ameerry1998/Nema-17-23-planetary-gear/variants/banebots-775-k6/THIRD-PARTY.md

# Attribution

The parent project is Omar Salem's `Nema-17-23-planetary-gear`, distributed under the MIT license retained at [the repository root](../../LICENSE). The original Fusion models, STEP files, assets and source retain their existing attribution.

The additional Python generator in this folder uses `cq_gears` at commit `e73874cf17a25447a99b1e7c22a4d5af38560e9c` as an external dependency. Its [source](https://github.com/meadiode/cq_gears/tree/e73874cf17a25447a99b1e7c22a4d5af38560e9c) is Apache-2.0 licensed. No copy of its library implementation is included in this fork addition; installation retrieves the dependency and its license.

The fit-test geometry was generated with that dependency. It is an independent preliminary fit study, not a conversion of Omar Salem's Fusion models and not a representation of his design's tested capacity.

New variant code and documentation are provided under the repository's MIT license. Initial preparation: Codex, October 21, 2026.
