ameerry1998/Nema-17-23-planetary-gear/variants/banebots-775-k6/drive-candidate/S2-internal-preview.png

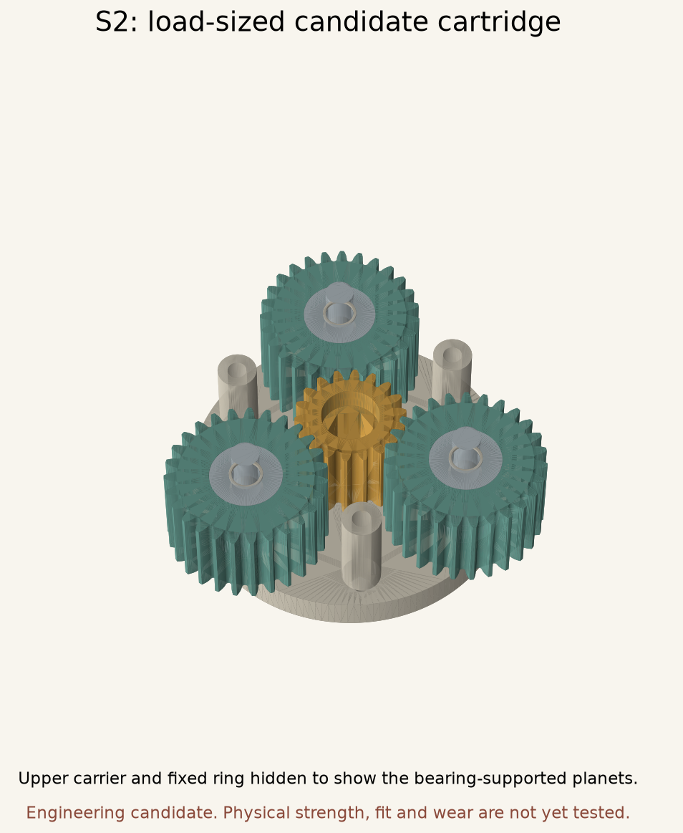
variants/banebots-775-k6/drive-candidate/S2-internal-preview.png
