ameerry1998/Nema-17-23-planetary-gear/variants/banebots-775-k6/cad/hand-test-assembly-REFERENCE.step

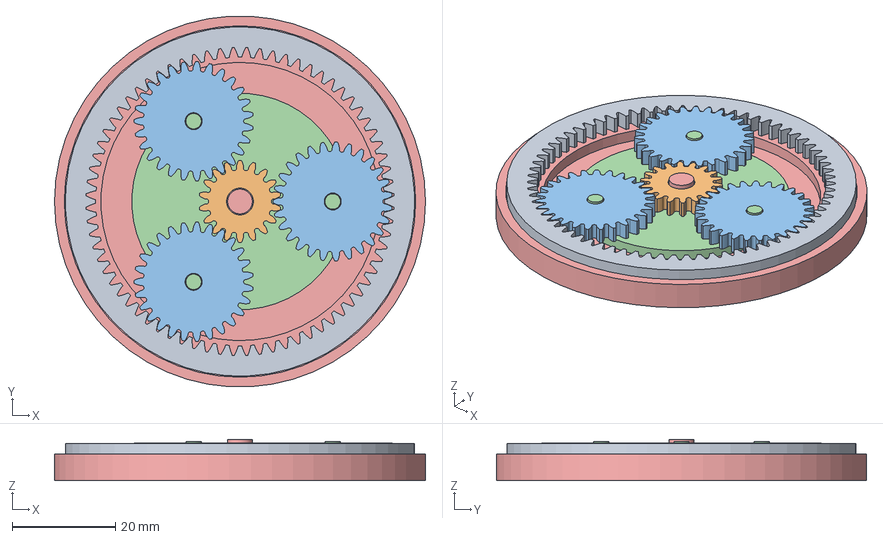
[picture p5: CAD file, 2026-10-21]
variants/banebots-775-k6/cad/hand-test-assembly-REFERENCE.step
72.0 x 71.9 x 8.00 mm
