ameerry1998/Nema-17-23-planetary-gear/variants/banebots-775-k6/drive-assembly/S2-output-cap-retainer-top.step

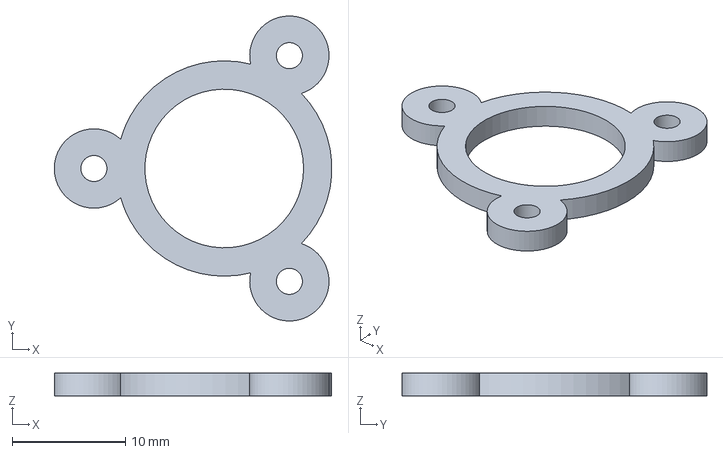
[picture p6: CAD file, 2026-10-21]
variants/banebots-775-k6/drive-assembly/S2-output-cap-retainer-top.step
24.5 x 26.9 x 2.00 mm
