ameerry1998/Nema-17-23-planetary-gear/variants/banebots-775-k6/drive-candidate/S2-sun.step

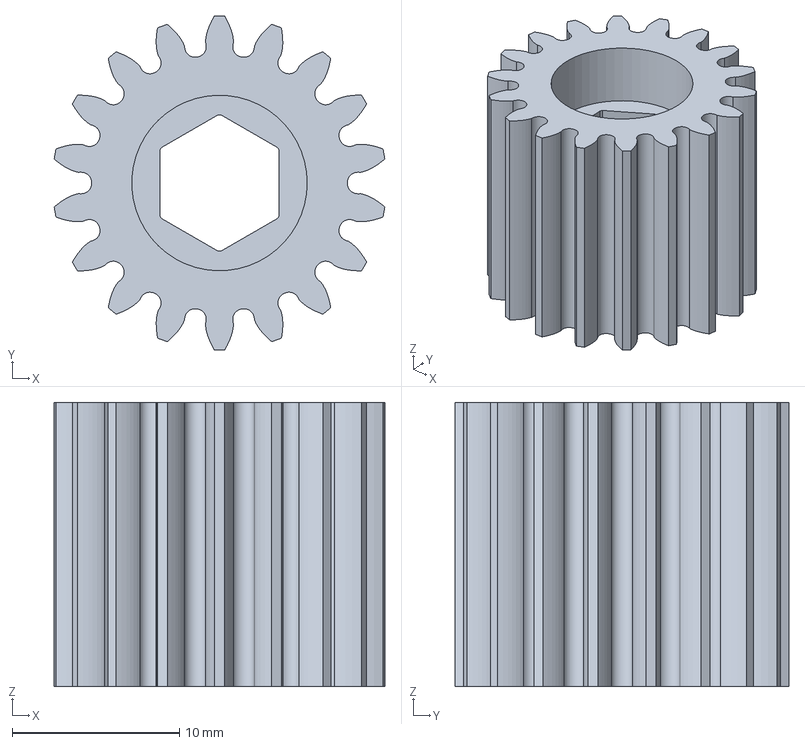
[picture p7: CAD file, 2026-10-21]
variants/banebots-775-k6/drive-candidate/S2-sun.step
19.8 x 20.0 x 17.0 mm
