ameerry1998/Nema-17-23-planetary-gear/variants/banebots-775-k6/fit-tests/shaft-fit-5.0mm-NO-POWER.step

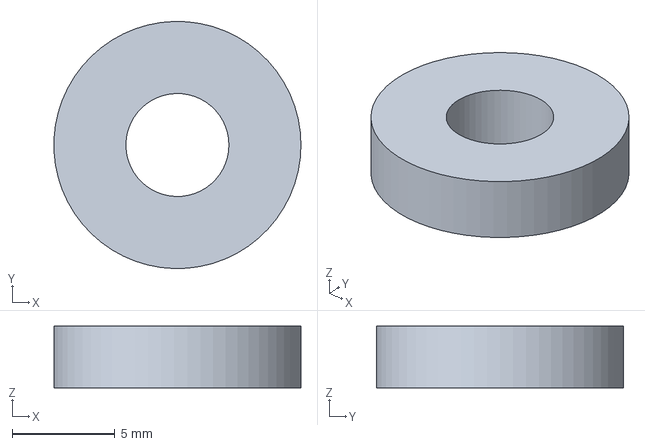
[picture p8: CAD file, 2026-10-21]
variants/banebots-775-k6/fit-tests/shaft-fit-5.0mm-NO-POWER.step
12.0 x 12.0 x 3.00 mm
