ameerry1998/Nema-17-23-planetary-gear/variants/banebots-775-k6/socket-adapter/SA1-REFERENCE.step

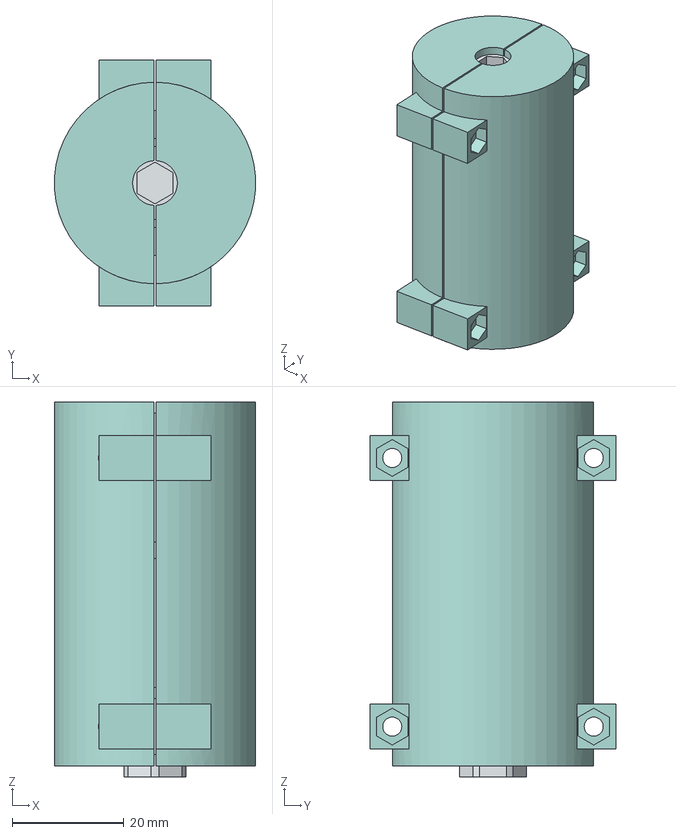
[picture p9: CAD file, 2026-10-21]
variants/banebots-775-k6/socket-adapter/SA1-REFERENCE.step
35.9 x 44.0 x 67.0 mm
left
right
input-steel-socket-envelope
output-steel-socket-envelope
steel-square-bridge-envelope
existing-metal-collar-envelope
12REX-output-shaft-envelope
