ameerry1998/Nema-17-23-planetary-gear/variants/banebots-775-k6/static-fixture/TF1-tie-rod-standoff-STATIC-ONLY.step

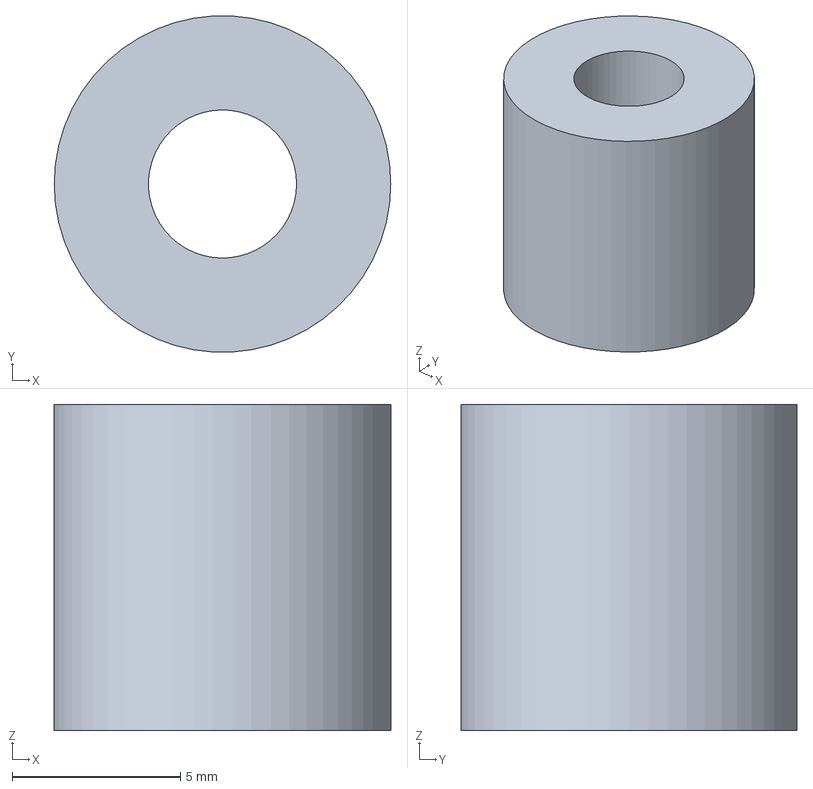
[picture p10: CAD file, 2026-10-21]
variants/banebots-775-k6/static-fixture/TF1-tie-rod-standoff-STATIC-ONLY.step
10.0 x 9.98 x 9.70 mm
