ameerry1998/Nema-17-23-planetary-gear/variants/banebots-775-k6/cad/single-stage-mesh-REFERENCE.step

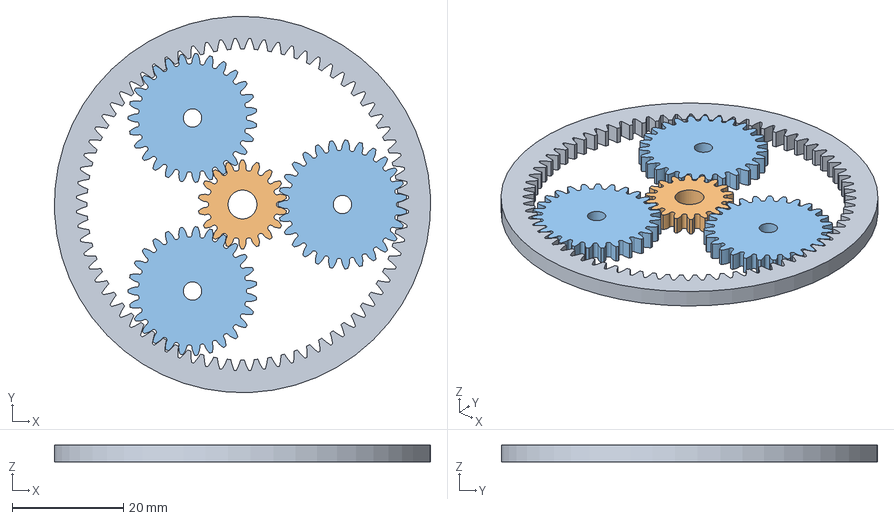
[picture p11: CAD file, 2026-10-21]
variants/banebots-775-k6/cad/single-stage-mesh-REFERENCE.step
67.7 x 67.7 x 3.00 mm
