ameerry1998/Nema-17-23-planetary-gear/variants/banebots-775-k6/drive-assembly/input-coupler-bearing-spacer.step

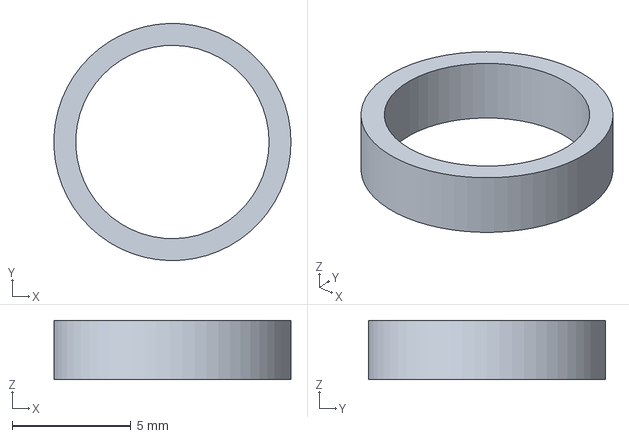
[picture p12: CAD file, 2026-10-21]
variants/banebots-775-k6/drive-assembly/input-coupler-bearing-spacer.step
9.99 x 10.00 x 2.50 mm
