ameerry1998/Nema-17-23-planetary-gear/variants/banebots-775-k6/drive-candidate/S2-carrier-upper.step

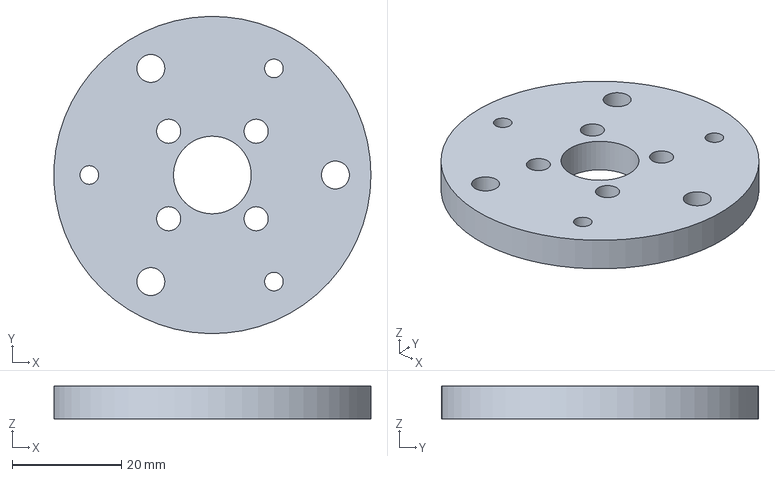
[picture p13: CAD file, 2026-10-21]
variants/banebots-775-k6/drive-candidate/S2-carrier-upper.step
58.0 x 58.0 x 6.00 mm
