ameerry1998/Nema-17-23-planetary-gear/variants/banebots-775-k6/fit-tests/motor-face-slotted-TEMPLATE-NO-POWER.step

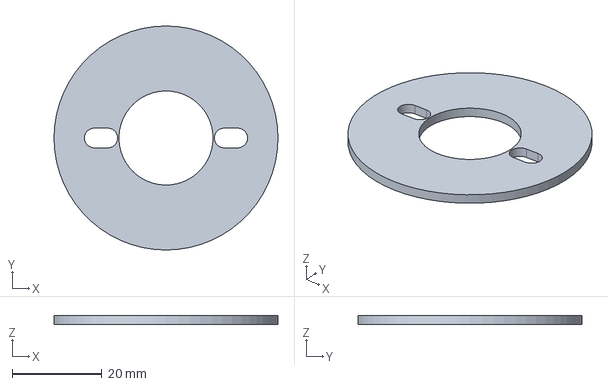
[picture p14: CAD file, 2026-10-21]
variants/banebots-775-k6/fit-tests/motor-face-slotted-TEMPLATE-NO-POWER.step
50.0 x 50.0 x 2.00 mm
