ameerry1998/Nema-17-23-planetary-gear/variants/banebots-775-k6/socket-adapter/SA1-cassette-right.step

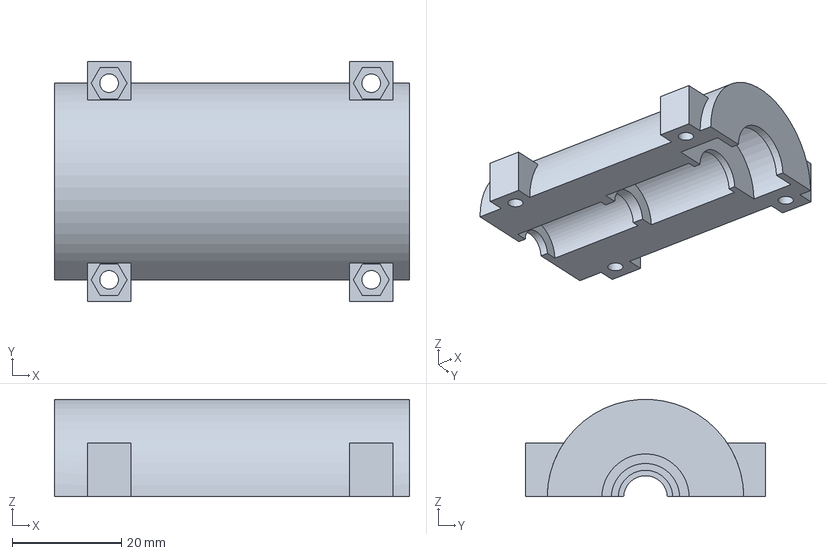
[picture p15: CAD file, 2026-10-21]
variants/banebots-775-k6/socket-adapter/SA1-cassette-right.step
65.0 x 44.0 x 17.8 mm
