ameerry1998/Nema-17-23-planetary-gear/variants/banebots-775-k6/static-fixture/TF1-vise-plate-MOTOR-REMOVED-ONLY.step

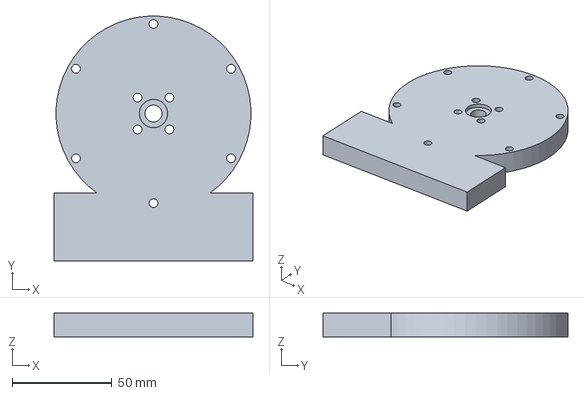
[picture p16: CAD file, 2026-10-21]
variants/banebots-775-k6/static-fixture/TF1-vise-plate-MOTOR-REMOVED-ONLY.step
100.0 x 122.9 x 12.0 mm
