ameerry1998/Nema-17-23-planetary-gear/variants/banebots-775-k6/drive-assembly/S2-case-lower.step

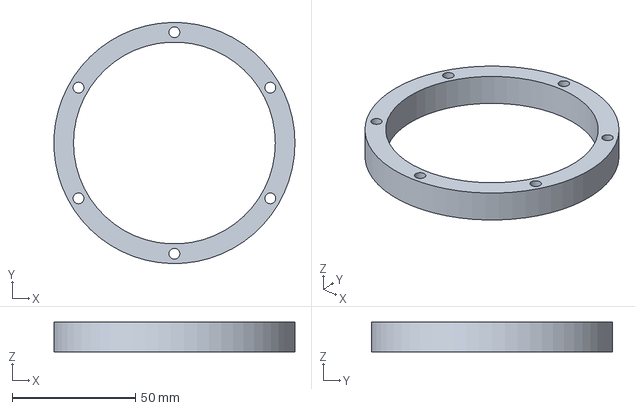
[picture p17: CAD file, 2026-10-21]
variants/banebots-775-k6/drive-assembly/S2-case-lower.step
97.9 x 98.0 x 12.0 mm
