ameerry1998/Nema-17-23-planetary-gear/variants/banebots-775-k6/socket-adapter/SA1-output-collar-spacer-FIT-SAMPLE.step

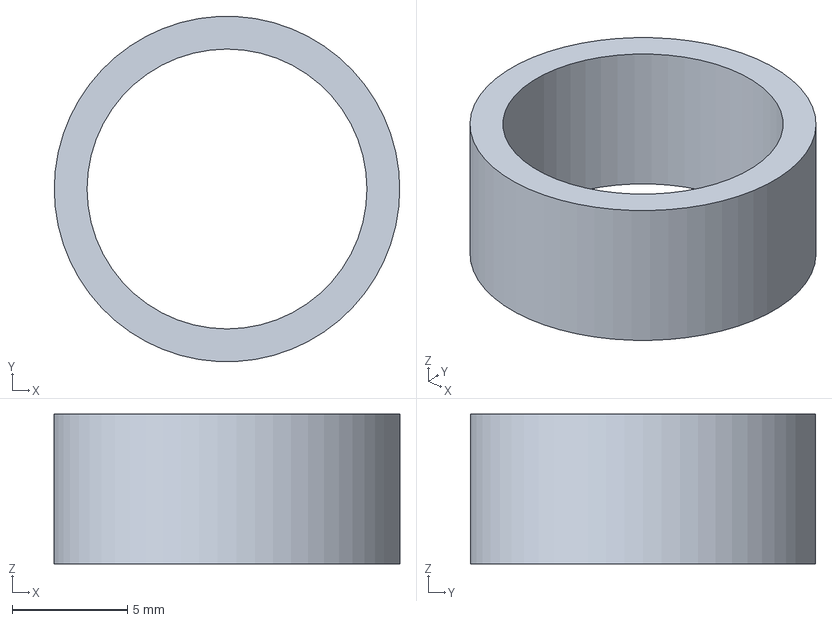
[picture p19: CAD file, 2026-10-21]
variants/banebots-775-k6/socket-adapter/SA1-output-collar-spacer-FIT-SAMPLE.step
15.0 x 15.0 x 6.50 mm
