ameerry1998/Nema-17-23-planetary-gear/variants/banebots-775-k6/static-fixture/TF1-STATIC-REFERENCE.step

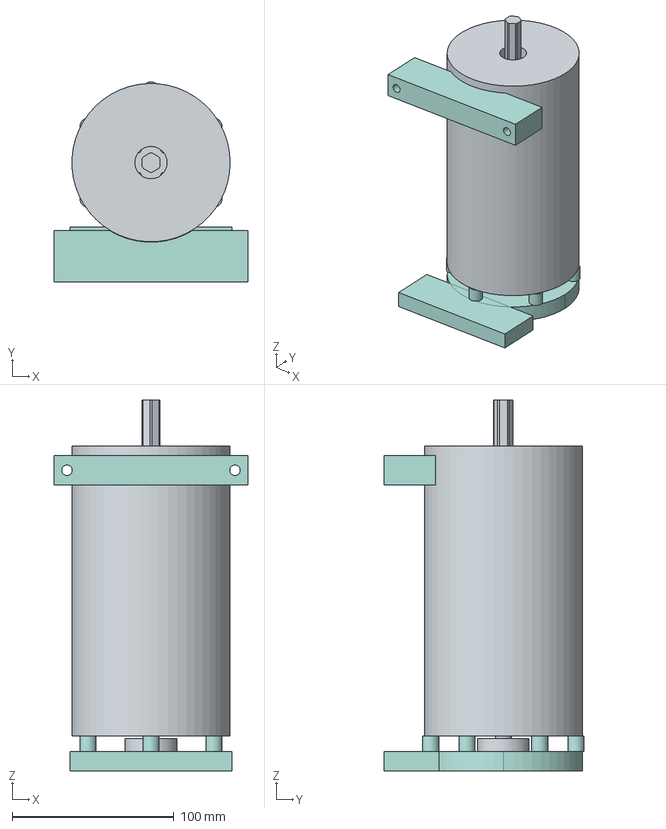
[picture p20: CAD file, 2026-10-21]
variants/banebots-775-k6/static-fixture/TF1-STATIC-REFERENCE.step
120.0 x 124.0 x 229.7 mm
vise-plate
rear-cradle
standoff-0
standoff-1
standoff-2
standoff-3
standoff-4
standoff-5
locking-hub-REFERENCE
input-shaft-REFERENCE
input-spacer-REFERENCE
hub-screw--8--8
hub-screw--8-8
hub-screw-8--8
hub-screw-8-8
gearbox-OUTER-ENVELOPE-ONLY
output-shaft-REFERENCE
