ameerry1998/Nema-17-23-planetary-gear/variants/banebots-775-k6/drive-assembly/S2-output-inner-spacer.step

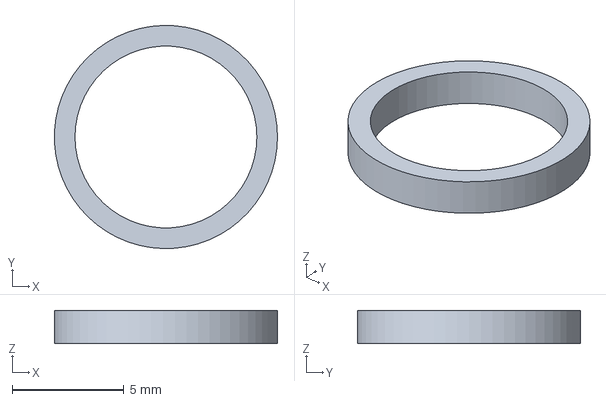
[picture p21: CAD file, 2026-10-21]
variants/banebots-775-k6/drive-assembly/S2-output-inner-spacer.step
9.99 x 10.00 x 1.50 mm
