ameerry1998/Nema-17-23-planetary-gear/variants/banebots-775-k6/drive-candidate/S1-planet.step

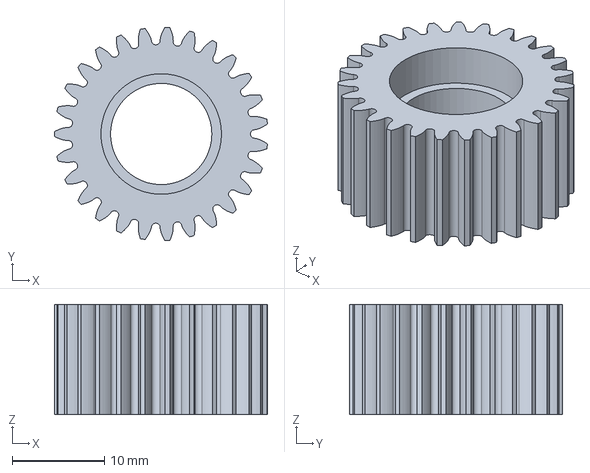
[picture p22: CAD file, 2026-10-21]
variants/banebots-775-k6/drive-candidate/S1-planet.step
23.1 x 23.2 x 12.0 mm
