ameerry1998/Nema-17-23-planetary-gear/variants/banebots-775-k6/static-fixture/TF1-rear-cradle-STATIC-ONLY.step

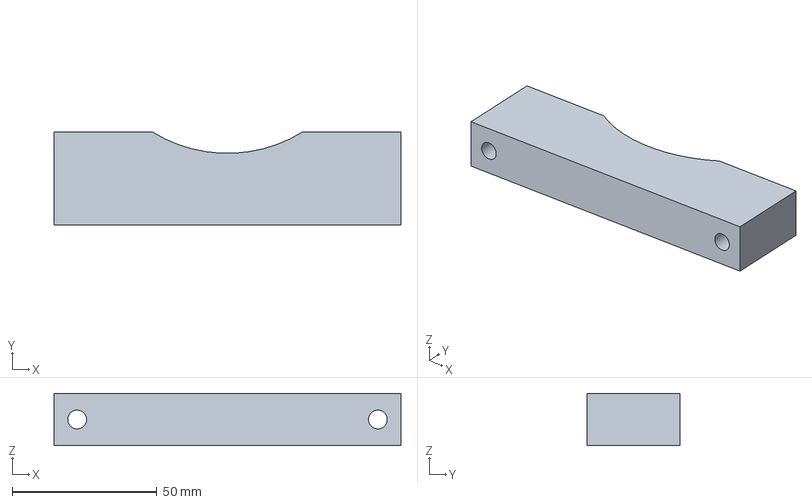
[picture p24: CAD file, 2026-10-21]
variants/banebots-775-k6/static-fixture/TF1-rear-cradle-STATIC-ONLY.step
120.0 x 32.0 x 18.0 mm
