ameerry1998/Nema-17-23-planetary-gear/variants/banebots-775-k6/drive-candidate/S1-carrier-lower.step

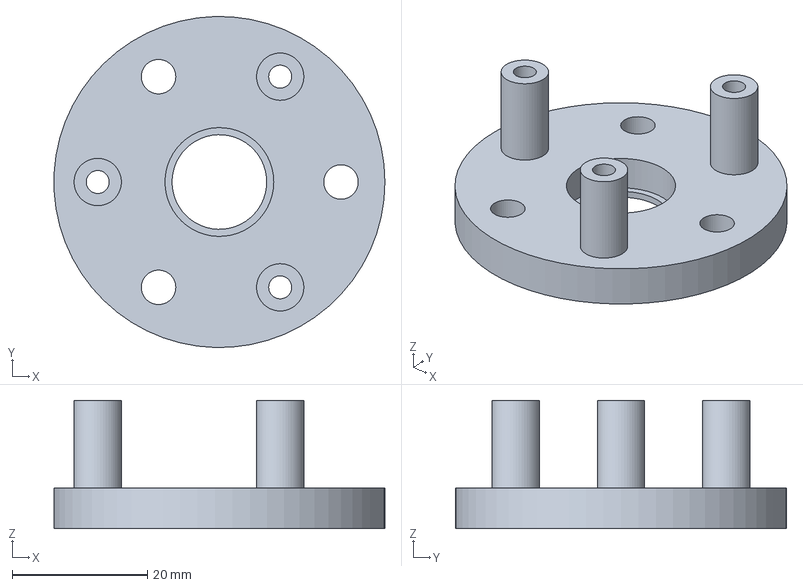
[picture p26: CAD file, 2026-10-21]
variants/banebots-775-k6/drive-candidate/S1-carrier-lower.step
49.0 x 49.0 x 19.0 mm
