ameerry1998/Nema-17-23-planetary-gear/variants/banebots-775-k6/drive-assembly/S3-output-cap.step

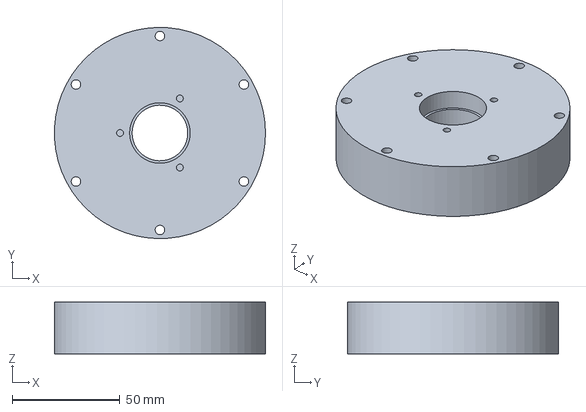
[picture p28: CAD file, 2026-10-21]
variants/banebots-775-k6/drive-assembly/S3-output-cap.step
97.9 x 98.0 x 24.0 mm
