ameerry1998/Nema-17-23-planetary-gear/variants/banebots-775-k6/fit-tests/carrier-HAND-TEST-ONLY.step

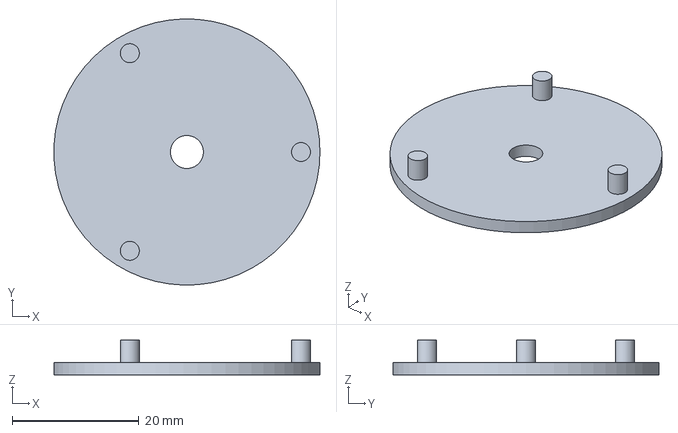
[picture p30: CAD file, 2026-10-21]
variants/banebots-775-k6/fit-tests/carrier-HAND-TEST-ONLY.step
42.0 x 42.0 x 5.50 mm
