ameerry1998/Nema-17-23-planetary-gear/variants/banebots-775-k6/fit-tests/ring-72T-HAND-TEST.step

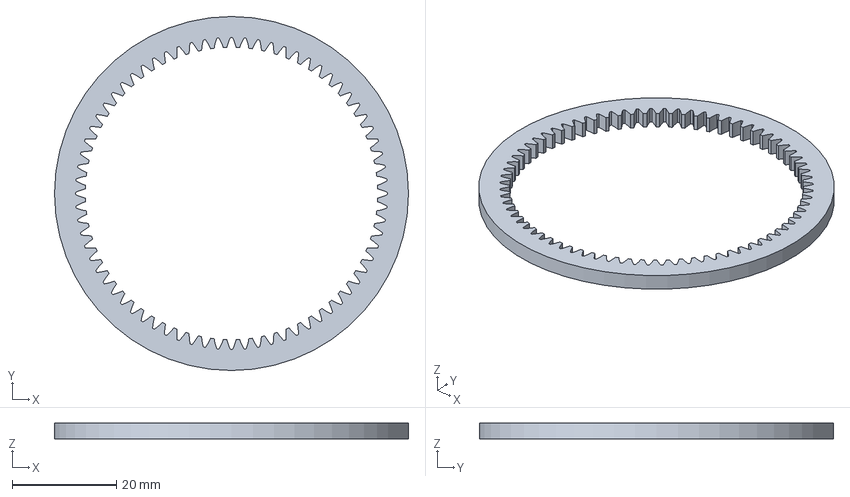
[picture p32: CAD file, 2026-10-21]
variants/banebots-775-k6/fit-tests/ring-72T-HAND-TEST.step
67.8 x 67.8 x 3.00 mm
