ameerry1998/Nema-17-23-planetary-gear/variants/banebots-775-k6/drive-assembly/S3-input-long-spacer.step

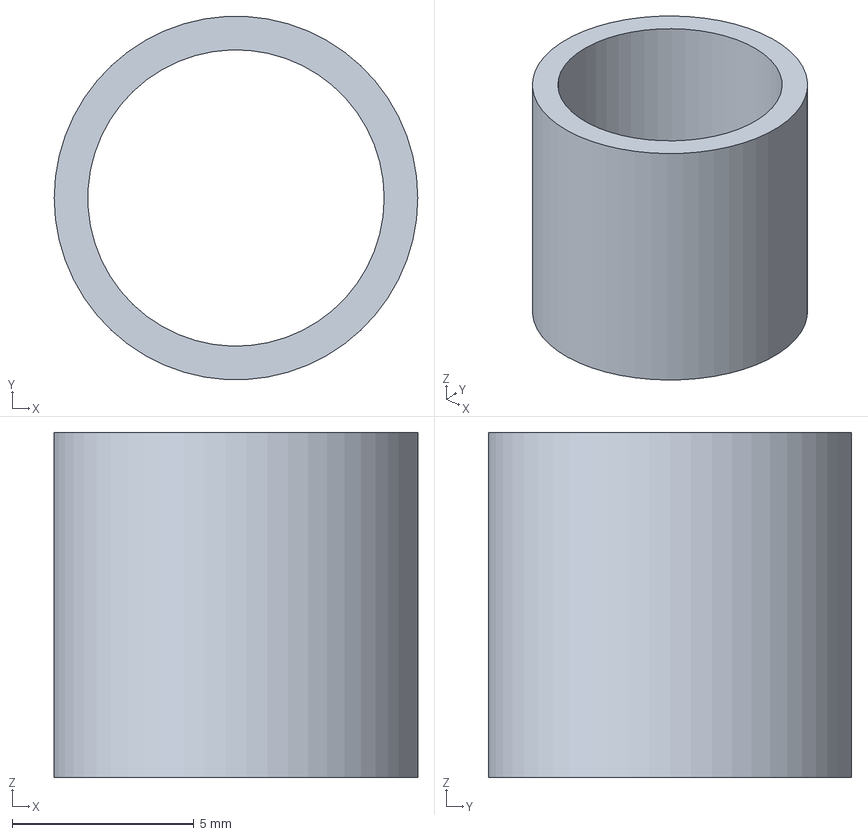
[picture p33: CAD file, 2026-10-21]
variants/banebots-775-k6/drive-assembly/S3-input-long-spacer.step
10.0 x 9.98 x 9.50 mm
