ameerry1998/Nema-17-23-planetary-gear/variants/banebots-775-k6/drive-candidate/S3-sun.step

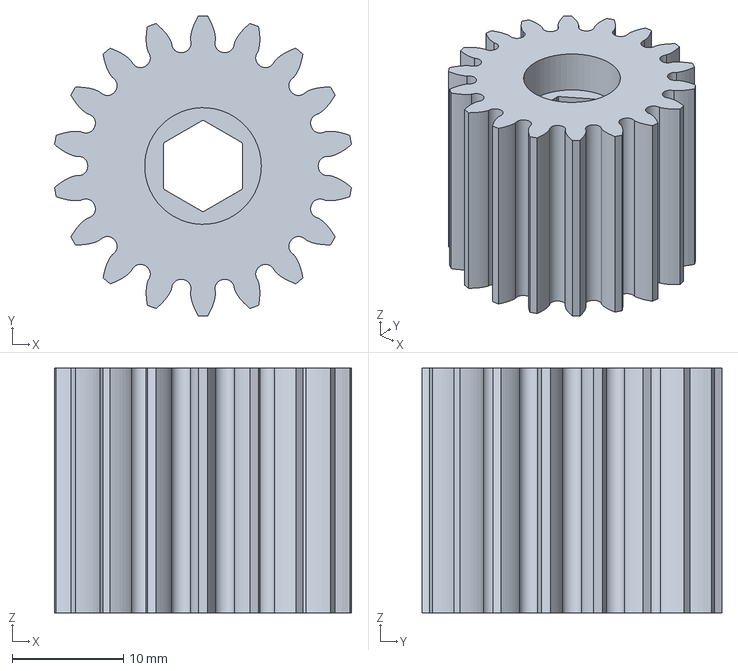
[picture p34: CAD file, 2026-10-21]
variants/banebots-775-k6/drive-candidate/S3-sun.step
26.7 x 27.0 x 22.0 mm
