ameerry1998/Nema-17-23-planetary-gear/variants/banebots-775-k6/fit-tests/sun-18T-HAND-TEST.step

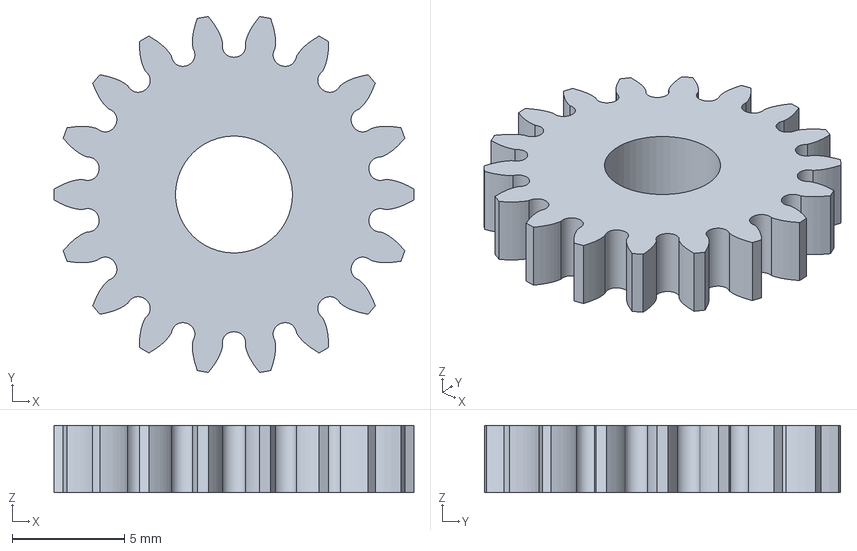
[picture p35: CAD file, 2026-10-21]
variants/banebots-775-k6/fit-tests/sun-18T-HAND-TEST.step
16.0 x 15.8 x 3.00 mm
