ameerry1998/Nema-17-23-planetary-gear/variants/banebots-775-k6/drive-assembly/D1-gearbox-REFERENCE.step

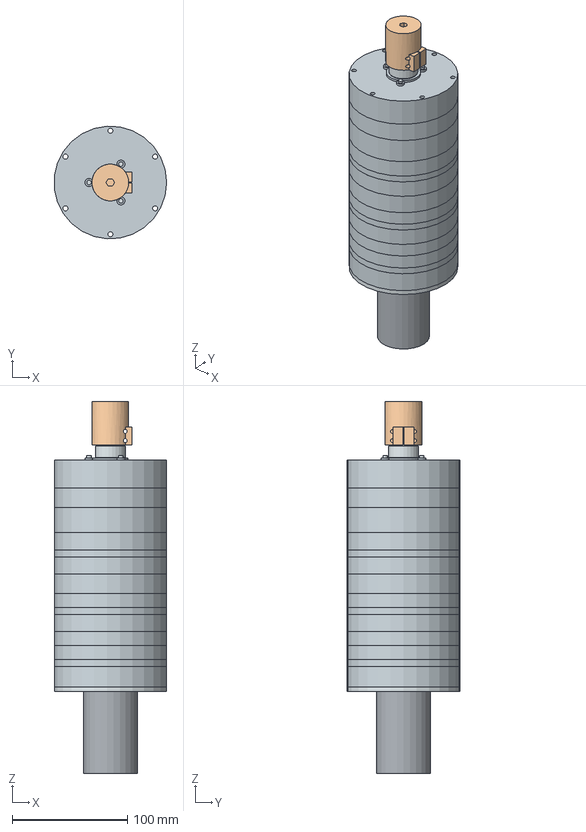
[picture p36: CAD file, 2026-10-21]
variants/banebots-775-k6/drive-assembly/D1-gearbox-REFERENCE.step
97.7 x 97.8 x 323.4 mm
input-bearing-cap
input-bearing-cap-bearing-0
input-bearing-cap-retainer-top
input-bearing-cap-retainer-top-M2-head-0
input-bearing-cap-retainer-top-M2-head-1
input-bearing-cap-retainer-top-M2-head-2
S1-lower
S1-upper
S1-ring
S1-sun
S1-carrier-journal
S1-planet-0
S1-planet-0-bearing-0
S1-planet-0-bearing-1
S1-planet-0-inner-spacer
S1-planet-0-end-spacer-0
S1-planet-0-end-spacer-1
S1-pin-0
S1-pin-upper-shim-0
S1-pin-washer-0
S1-pin-nut-0
S1-planet-1
S1-planet-1-bearing-0
S1-planet-1-bearing-1
S1-planet-1-inner-spacer
S1-planet-1-end-spacer-0
S1-planet-1-end-spacer-1
S1-pin-1
S1-pin-upper-shim-1
S1-pin-washer-1
S1-pin-nut-1
S1-planet-2
S1-planet-2-bearing-0
S1-planet-2-bearing-1
S1-planet-2-inner-spacer
S1-planet-2-end-spacer-0
S1-planet-2-end-spacer-1
S1-pin-2
S1-pin-upper-shim-2
S1-pin-washer-2
S1-pin-nut-2
S1-post-screw-0
S1-post-screw-1
S1-post-screw-2
S1-output-shaft-REFERENCE
S1-case-lower
S1-case-upper
S1-output-cap
S1-output-cap-bearing-0
S1-output-cap-retainer-top
S1-output-cap-retainer-top-M2-head-0
S1-output-cap-retainer-top-M2-head-1
S1-output-cap-retainer-top-M2-head-2
S2-lower
S2-upper
S2-metal-hub-bolt--8--8
S2-metal-hub-bolt--8-8
S2-metal-hub-bolt-8--8
S2-metal-hub-bolt-8-8
S2-metal-hub-REFERENCE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
