ameerry1998/Nema-17-23-planetary-gear/variants/banebots-775-k6/drive-candidate/S3-planet-end-spacer.step

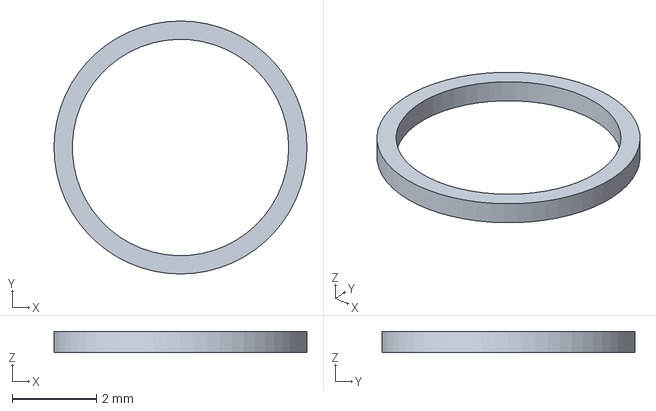
[picture p37: CAD file, 2026-10-21]
variants/banebots-775-k6/drive-candidate/S3-planet-end-spacer.step
6.00 x 6.00 x 0.5 mm
