ameerry1998/Nema-17-23-planetary-gear/variants/banebots-775-k6/fit-tests/bearing-seat-11.2mm-NO-POWER.step

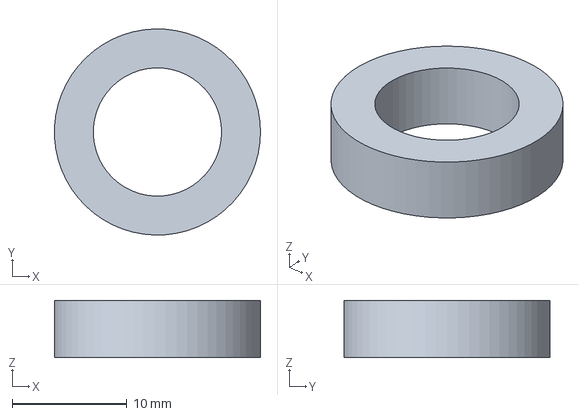
[picture p38: CAD file, 2026-10-21]
variants/banebots-775-k6/fit-tests/bearing-seat-11.2mm-NO-POWER.step
18.0 x 18.0 x 5.00 mm
