ameerry1998/Nema-17-23-planetary-gear/variants/banebots-775-k6/drive-assembly/output-collar-spacer.step

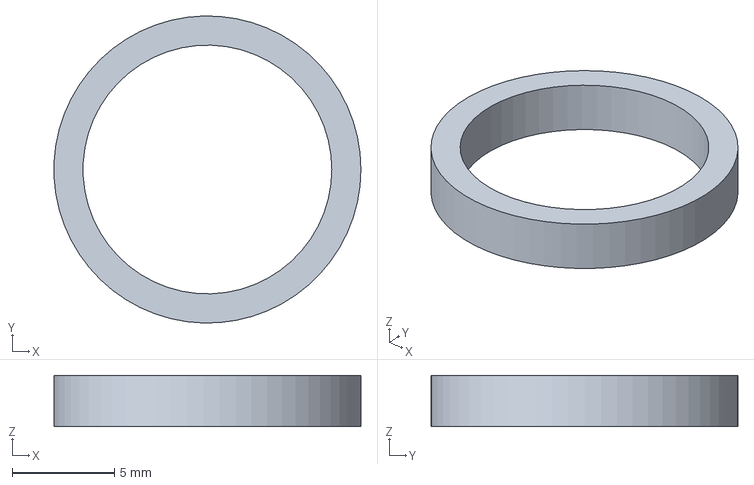
[picture p40: CAD file, 2026-10-21]
variants/banebots-775-k6/drive-assembly/output-collar-spacer.step
15.0 x 15.0 x 2.50 mm
