ameerry1998/Nema-17-23-planetary-gear/variants/banebots-775-k6/drive-assembly/motor-face-plate.step

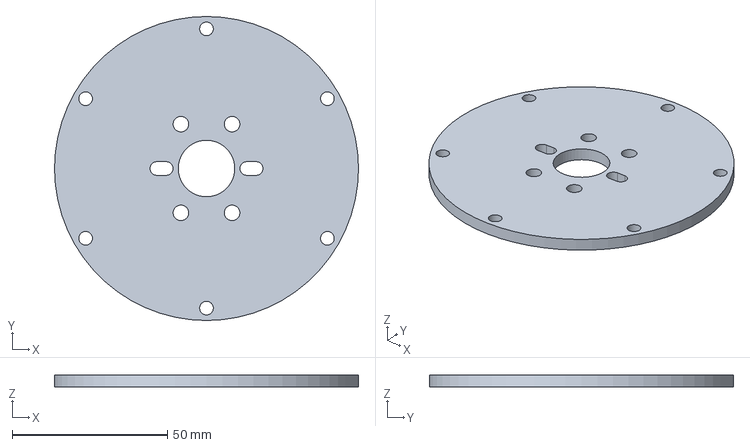
[picture p42: CAD file, 2026-10-21]
variants/banebots-775-k6/drive-assembly/motor-face-plate.step
98.0 x 98.0 x 4.00 mm
