ameerry1998/Nema-17-23-planetary-gear/variants/banebots-775-k6/fit-tests/stand-HAND-TEST-ONLY.step

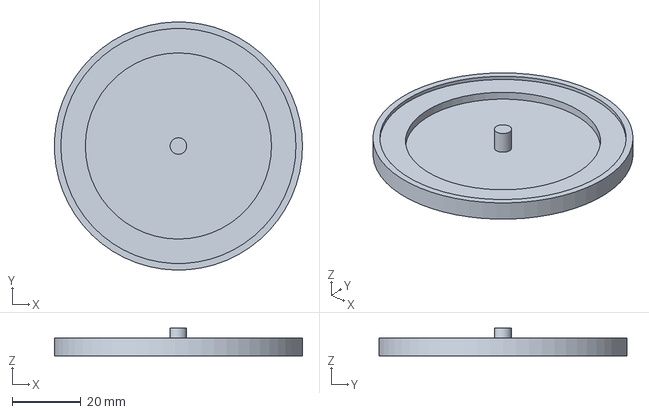
[picture p44: CAD file, 2026-10-21]
variants/banebots-775-k6/fit-tests/stand-HAND-TEST-ONLY.step
71.9 x 72.0 x 8.00 mm
