ameerry1998/Nema-17-23-planetary-gear/variants/banebots-775-k6/drive-assembly/motor-coupler-guard.step

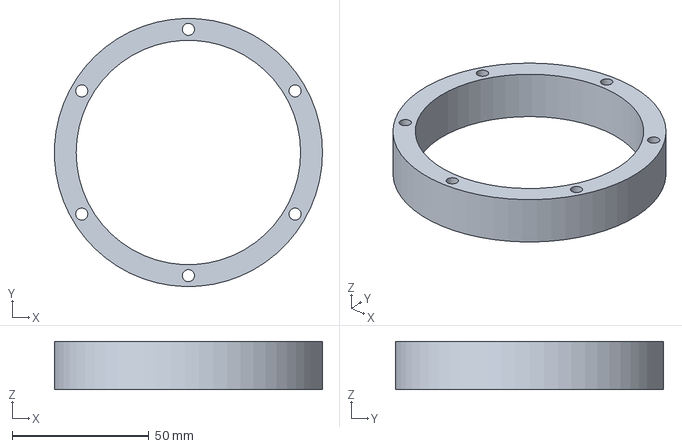
[picture p45: CAD file, 2026-10-21]
variants/banebots-775-k6/drive-assembly/motor-coupler-guard.step
97.9 x 98.0 x 17.6 mm
