ameerry1998/Nema-17-23-planetary-gear/variants/banebots-775-k6/drive-candidate/S3-carrier-upper.step

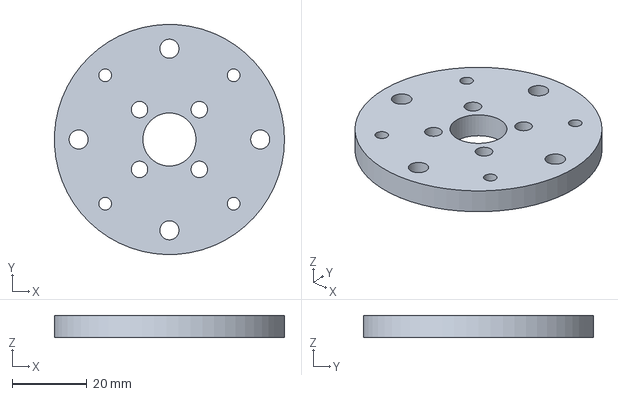
[picture p46: CAD file, 2026-10-21]
variants/banebots-775-k6/drive-candidate/S3-carrier-upper.step
61.6 x 61.6 x 6.00 mm
