ameerry1998/Nema-17-23-planetary-gear/variants/banebots-775-k6/fit-tests/planet-27T-HAND-TEST-print-three.step

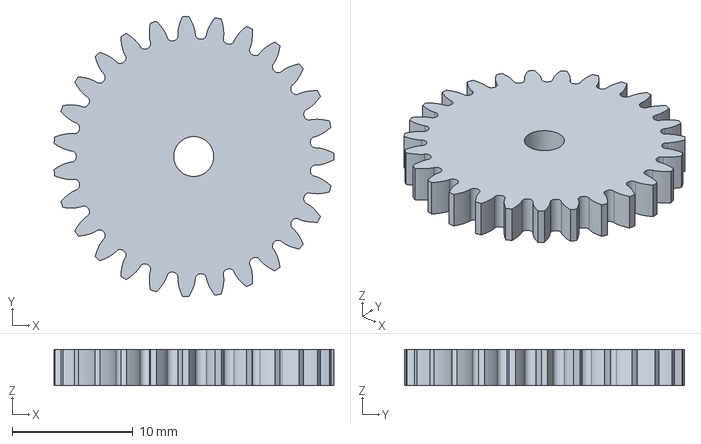
[picture p47: CAD file, 2026-10-21]
variants/banebots-775-k6/fit-tests/planet-27T-HAND-TEST-print-three.step
23.1 x 23.2 x 3.00 mm
