ameerry1998/Nema-17-23-planetary-gear/variants/banebots-775-k6/drive-assembly/S2-input-short-spacer.step

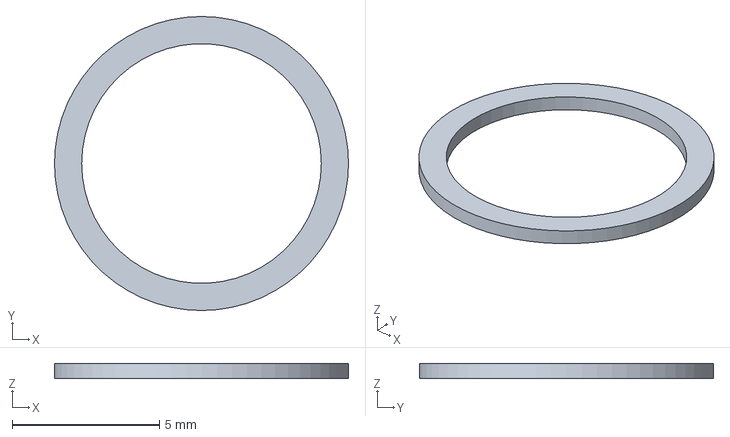
[picture p48: CAD file, 2026-10-21]
variants/banebots-775-k6/drive-assembly/S2-input-short-spacer.step
10.0 x 10.0 x 0.5 mm
