ameerry1998/Nema-17-23-planetary-gear/variants/banebots-775-k6/drive-candidate/S1-sun.step

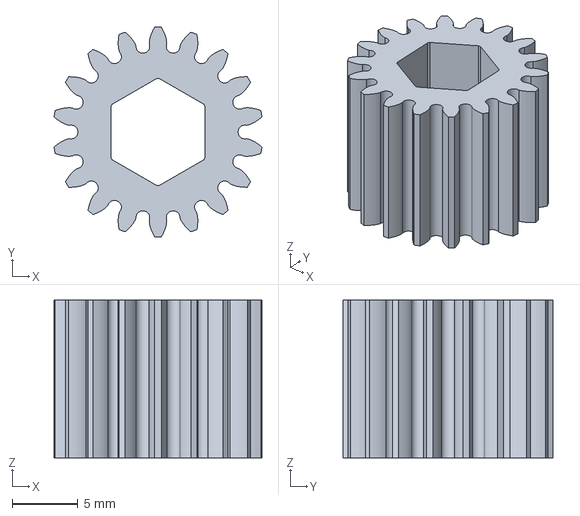
[picture p49: CAD file, 2026-10-21]
variants/banebots-775-k6/drive-candidate/S1-sun.step
15.8 x 16.0 x 12.0 mm
