ameerry1998/Nema-17-23-planetary-gear/variants/banebots-775-k6/drive-candidate/S1-planet-inner-spacer.step

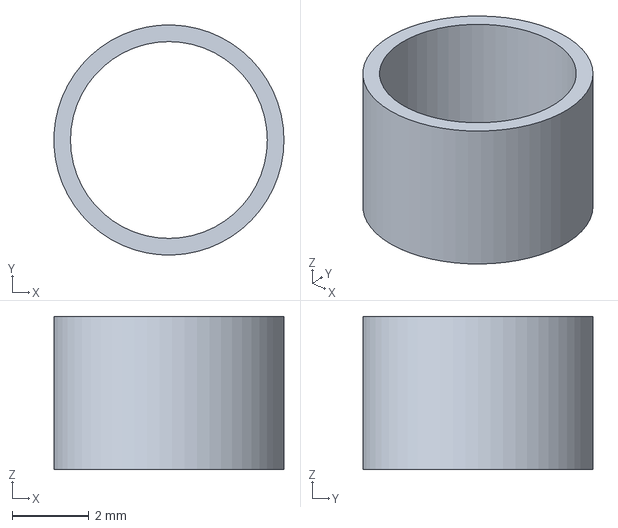
[picture p50: CAD file, 2026-10-21]
variants/banebots-775-k6/drive-candidate/S1-planet-inner-spacer.step
6.00 x 6.00 x 4.00 mm
