ameerry1998/Nema-17-23-planetary-gear/variants/banebots-775-k6/drive-assembly/adapter-12REX-to-quarter-inch-hex-FIT-AND-LOAD-TEST.step

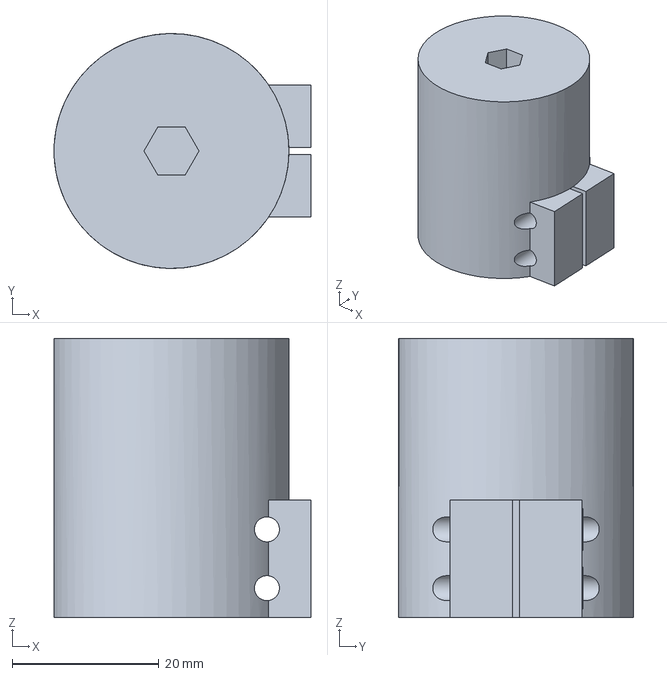
[picture p51: CAD file, 2026-10-21]
variants/banebots-775-k6/drive-assembly/adapter-12REX-to-quarter-inch-hex-FIT-AND-LOAD-TEST.step
35.0 x 32.0 x 38.0 mm
