ameerry1998/Nema-17-23-planetary-gear/variants/banebots-775-k6/drive-candidate/S2-carrier-lower.step

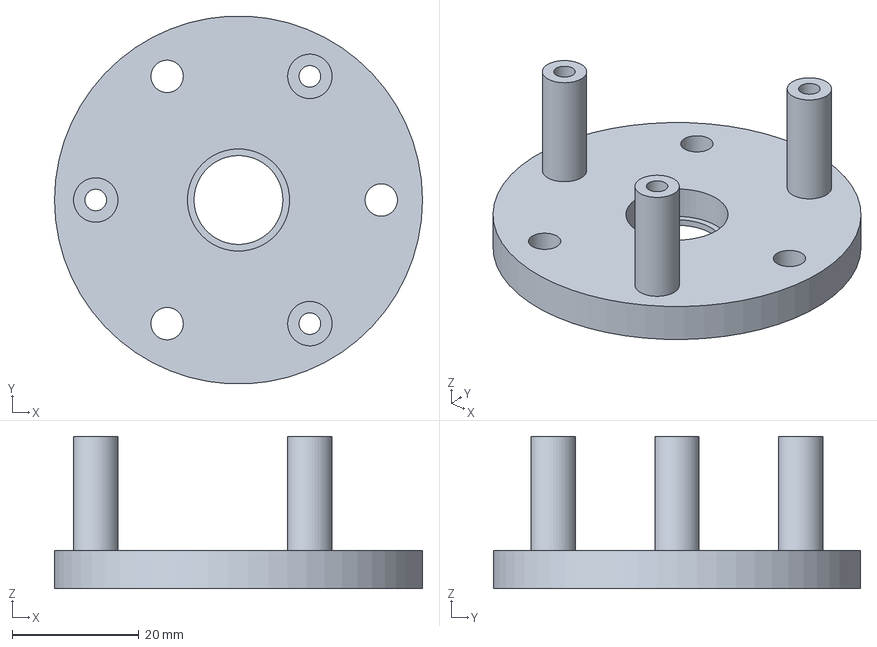
[picture p52: CAD file, 2026-10-21]
variants/banebots-775-k6/drive-candidate/S2-carrier-lower.step
58.0 x 57.9 x 24.0 mm
