ameerry1998/Nema-17-23-planetary-gear/variants/banebots-775-k6/drive-candidate/S1-cartridge-REFERENCE.step

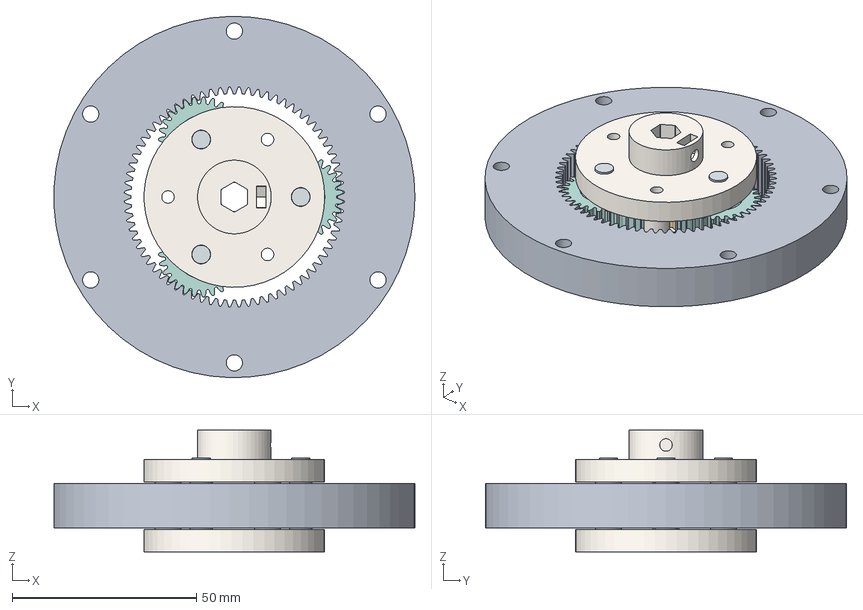
[picture p53: CAD file, 2026-10-21]
variants/banebots-775-k6/drive-candidate/S1-cartridge-REFERENCE.step
97.9 x 98.0 x 33.0 mm
ring
sun
lower
upper
planet-0
bearing-0-6_5
bearing-0-14_5
inner-spacer-0
end-spacer-0-6
end-spacer-0-18_5
pin-0
planet-1
bearing-1-6_5
bearing-1-14_5
inner-spacer-1
end-spacer-1-6
end-spacer-1-18_5
pin-1
planet-2
bearing-2-6_5
bearing-2-14_5
inner-spacer-2
end-spacer-2-6
end-spacer-2-18_5
pin-2
carrier-journal
