ameerry1998/Nema-17-23-planetary-gear/variants/banebots-775-k6/drive-candidate/S2-planet-inner-spacer.step

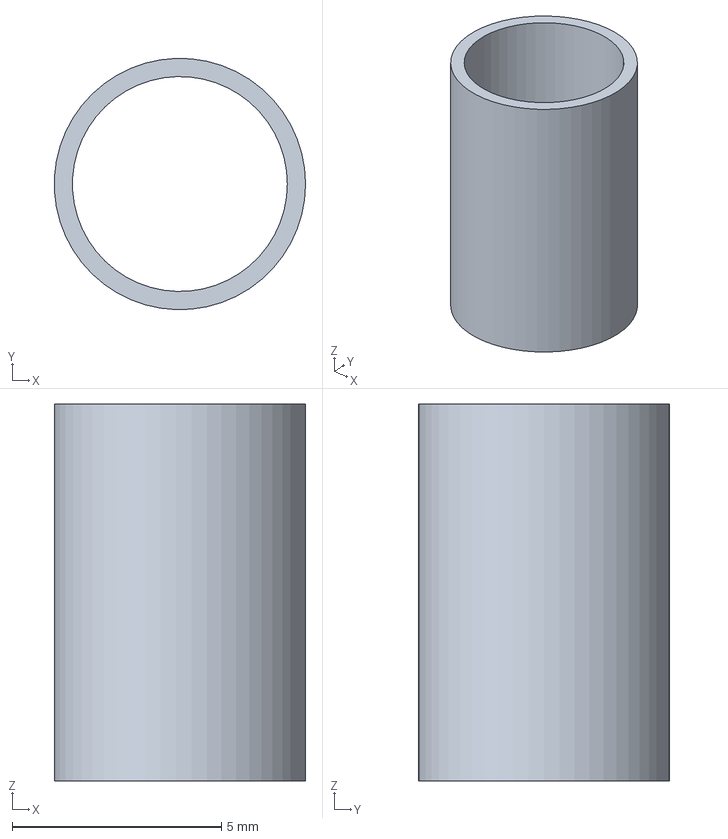
[picture p54: CAD file, 2026-10-21]
variants/banebots-775-k6/drive-candidate/S2-planet-inner-spacer.step
5.99 x 6.00 x 9.00 mm
