ameerry1998/Nema-17-23-planetary-gear/variants/banebots-775-k6/drive-assembly/S2-output-cap.step

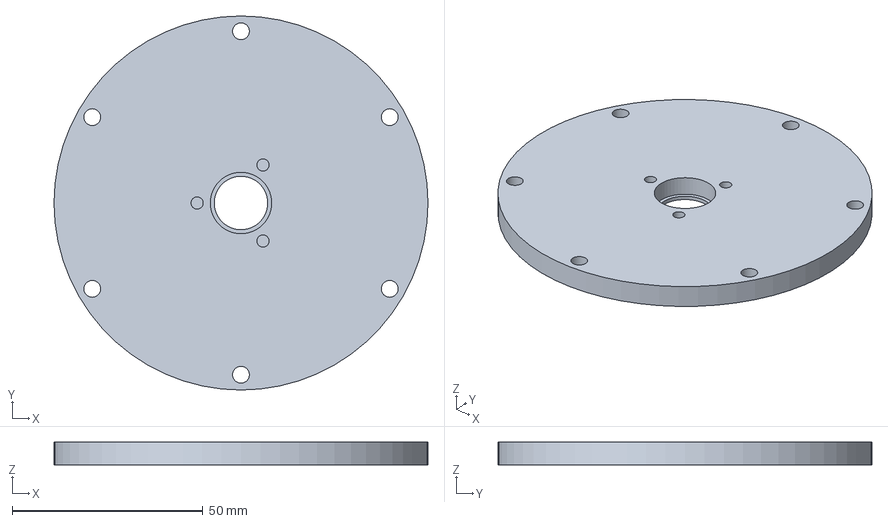
[picture p55: CAD file, 2026-10-21]
variants/banebots-775-k6/drive-assembly/S2-output-cap.step
98.0 x 98.0 x 6.00 mm
