ameerry1998/Nema-17-23-planetary-gear/variants/banebots-775-k6/drive-assembly/S3-output-cap-retainer-top.step

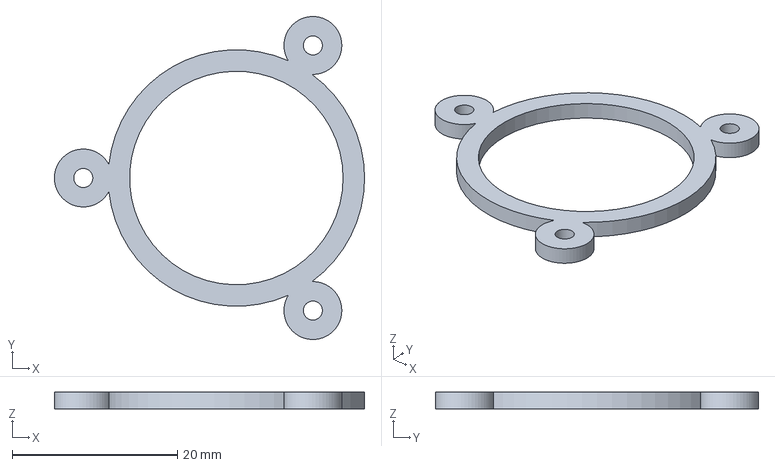
[picture p56: CAD file, 2026-10-21]
variants/banebots-775-k6/drive-assembly/S3-output-cap-retainer-top.step
37.5 x 39.0 x 2.00 mm
