ameerry1998/Nema-17-23-planetary-gear/variants/banebots-775-k6/drive-candidate/S3-carrier-lower.step

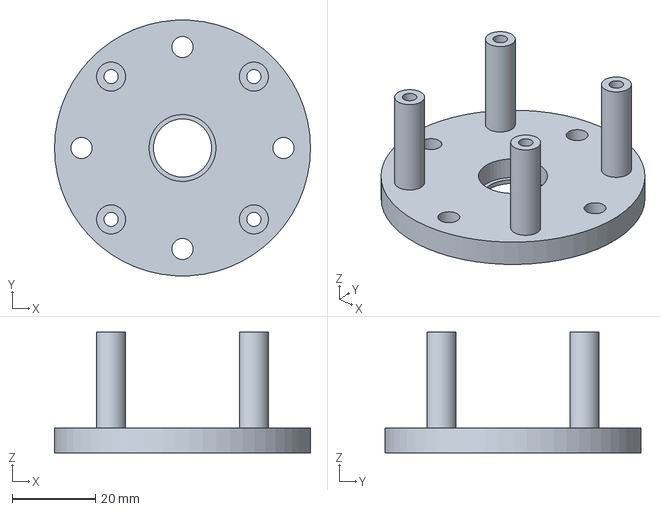
[picture p57: CAD file, 2026-10-21]
variants/banebots-775-k6/drive-candidate/S3-carrier-lower.step
61.6 x 61.5 x 29.0 mm
