ameerry1998/Nema-17-23-planetary-gear/variants/banebots-775-k6/drive-assembly/S1-input-long-spacer.step

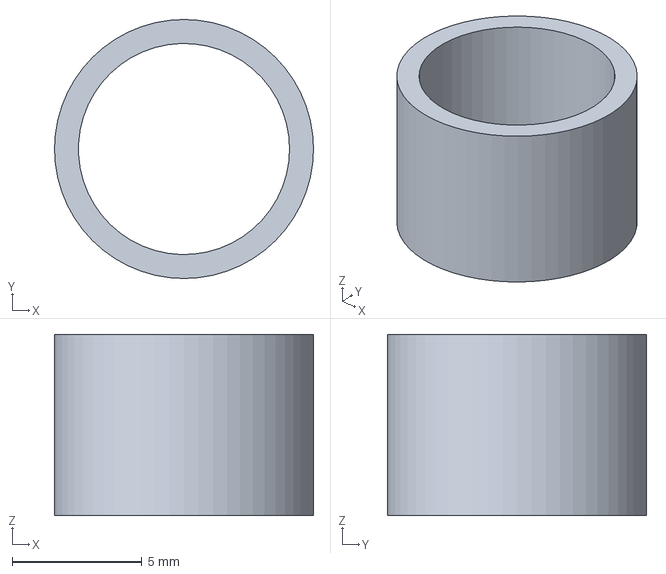
[picture p58: CAD file, 2026-10-21]
variants/banebots-775-k6/drive-assembly/S1-input-long-spacer.step
10.0 x 10.0 x 7.00 mm
