ameerry1998/Nema-17-23-planetary-gear/variants/banebots-775-k6/drive-candidate/S3-fixed-ring.step

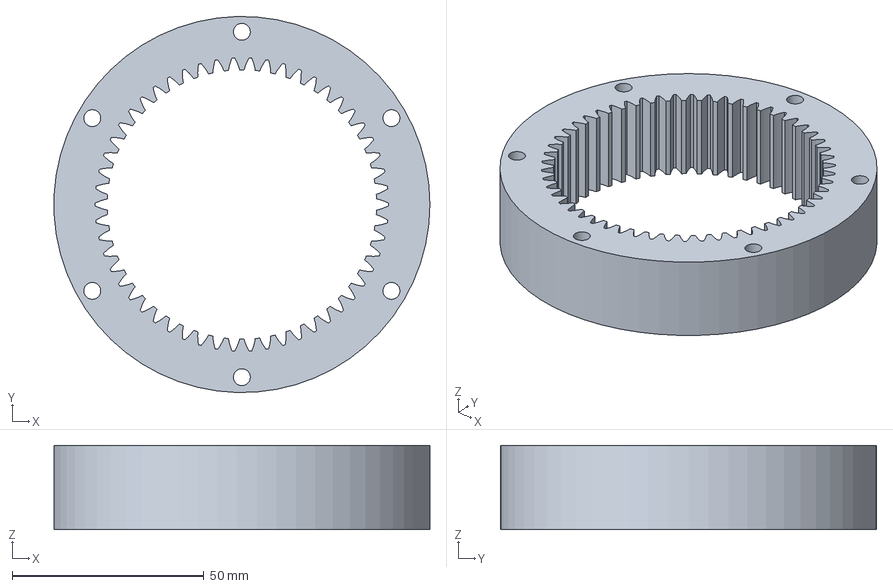
[picture p59: CAD file, 2026-10-21]
variants/banebots-775-k6/drive-candidate/S3-fixed-ring.step
97.9 x 98.0 x 22.0 mm
