ameerry1998/Nema-17-23-planetary-gear/variants/banebots-775-k6/drive-candidate/S2-planet.step

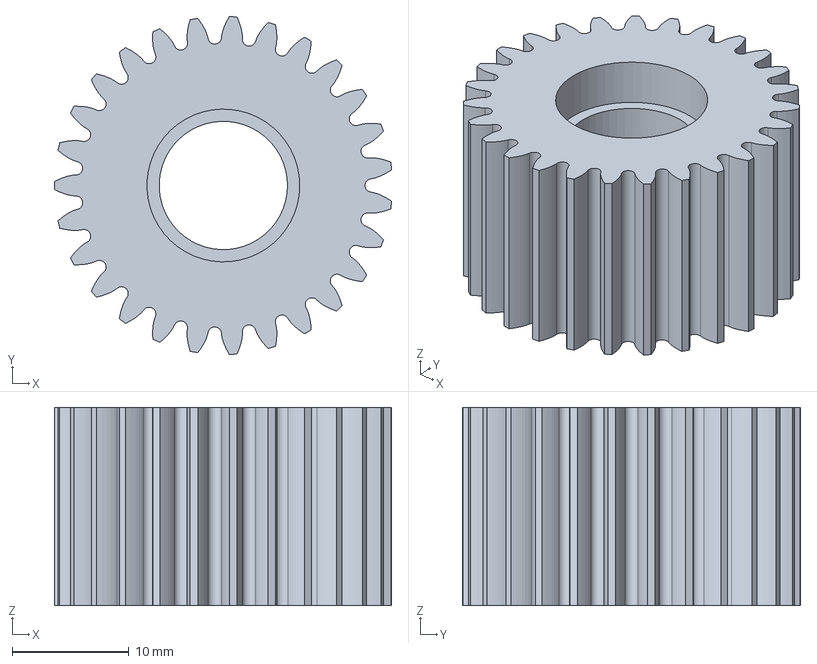
[picture p61: CAD file, 2026-10-21]
variants/banebots-775-k6/drive-candidate/S2-planet.step
28.9 x 29.0 x 17.0 mm
