ameerry1998/Nema-17-23-planetary-gear/variants/banebots-775-k6/drive-assembly/S3-case-upper.step

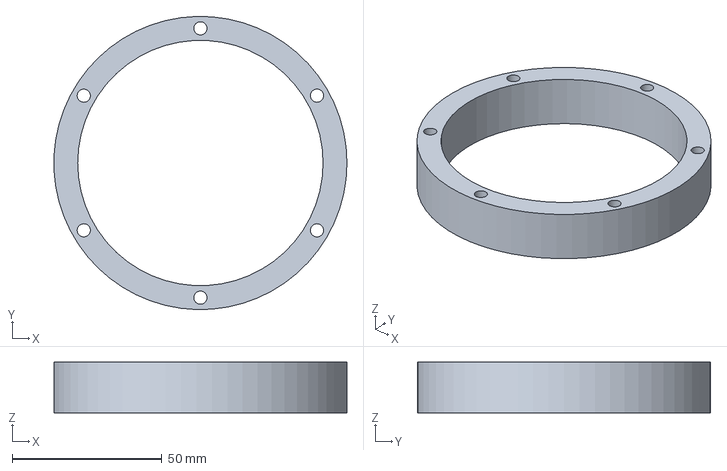
[picture p63: CAD file, 2026-10-21]
variants/banebots-775-k6/drive-assembly/S3-case-upper.step
97.9 x 98.0 x 17.0 mm
