ameerry1998/Nema-17-23-planetary-gear/variants/banebots-775-k6/drive-assembly/output-bearing-separator.step

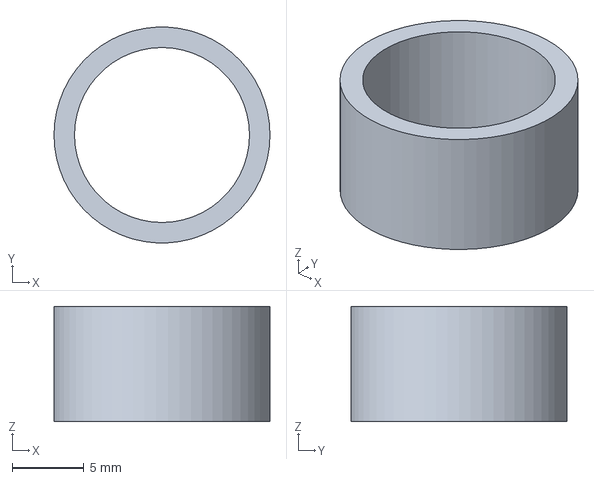
[picture p64: CAD file, 2026-10-21]
variants/banebots-775-k6/drive-assembly/output-bearing-separator.step
15.0 x 15.0 x 8.00 mm
