ameerry1998/Nema-17-23-planetary-gear/(list of files, cad)

Other CAD files:
variants/banebots-775-k6/fit-tests/shaft-fit-5.2mm-NO-POWER.step
variants/banebots-775-k6/fit-tests/shaft-fit-5.1mm-NO-POWER.step
variants/banebots-775-k6/drive-assembly/S1-output-inner-spacer.step
variants/banebots-775-k6/drive-assembly/S1-output-cap-retainer-top.step
variants/banebots-775-k6/fit-tests/bearing-seat-11.1mm-NO-POWER.step
variants/banebots-775-k6/fit-tests/bearing-seat-11.0mm-NO-POWER.step
variants/banebots-775-k6/drive-assembly/S1-case-lower.step
variants/banebots-775-k6/drive-assembly/S2-case-upper.step
variants/banebots-775-k6/drive-assembly/S3-output-inner-spacer.step
variants/banebots-775-k6/drive-candidate/S2-planet-end-spacer.step
variants/banebots-775-k6/drive-assembly/input-bearing-cap.step
variants/banebots-775-k6/drive-assembly/input-bearing-cap-retainer-top.step
variants/banebots-775-k6/drive-candidate/S1-planet-end-spacer.step
variants/banebots-775-k6/drive-assembly/S3-input-short-spacer.step
variants/banebots-775-k6/drive-assembly/S3-output-cap-retainer-bottom.step
variants/banebots-775-k6/drive-assembly/S3-case-lower.step
variants/banebots-775-k6/drive-assembly/S1-input-short-spacer.step
variants/banebots-775-k6/drive-assembly/S1-output-cap.step
variants/banebots-775-k6/drive-assembly/S1-case-lower.stl
variants/banebots-775-k6/drive-assembly/S1-case-upper.stl
variants/banebots-775-k6/drive-assembly/S1-input-long-spacer.stl
variants/banebots-775-k6/drive-assembly/S1-input-short-spacer.stl
variants/banebots-775-k6/drive-assembly/S1-output-cap-retainer-top.stl
variants/banebots-775-k6/drive-assembly/S1-output-cap.stl
variants/banebots-775-k6/drive-assembly/S1-output-inner-spacer.stl
variants/banebots-775-k6/drive-assembly/S2-case-lower.stl
variants/banebots-775-k6/drive-assembly/S2-case-upper.stl
variants/banebots-775-k6/drive-assembly/S2-input-long-spacer.stl
variants/banebots-775-k6/drive-assembly/S2-input-short-spacer.stl
variants/banebots-775-k6/drive-assembly/S2-output-cap-retainer-top.stl
variants/banebots-775-k6/drive-assembly/S2-output-cap.stl
variants/banebots-775-k6/drive-assembly/S2-output-inner-spacer.stl
variants/banebots-775-k6/drive-assembly/S3-case-lower.stl
variants/banebots-775-k6/drive-assembly/S3-case-upper.stl
variants/banebots-775-k6/drive-assembly/S3-input-long-spacer.stl
variants/banebots-775-k6/drive-assembly/S3-input-short-spacer.stl
variants/banebots-775-k6/drive-assembly/S3-output-cap-retainer-bottom.stl
variants/banebots-775-k6/drive-assembly/S3-output-cap-retainer-top.stl
variants/banebots-775-k6/drive-assembly/S3-output-cap.stl
variants/banebots-775-k6/drive-assembly/S3-output-inner-spacer.stl
variants/banebots-775-k6/drive-assembly/adapter-12REX-to-quarter-inch-hex-FIT-AND-LOAD-TEST.stl
variants/banebots-775-k6/drive-assembly/input-bearing-cap-retainer-top.stl
variants/banebots-775-k6/drive-assembly/input-bearing-cap.stl
variants/banebots-775-k6/drive-assembly/input-coupler-bearing-spacer.stl
variants/banebots-775-k6/drive-assembly/motor-coupler-guard.stl
variants/banebots-775-k6/drive-assembly/motor-face-plate.stl
variants/banebots-775-k6/drive-assembly/output-bearing-separator.stl
variants/banebots-775-k6/drive-assembly/output-collar-spacer.stl
variants/banebots-775-k6/drive-candidate/S1-carrier-lower.stl
variants/banebots-775-k6/drive-candidate/S1-carrier-upper.stl
variants/banebots-775-k6/drive-candidate/S1-fixed-ring.stl
variants/banebots-775-k6/drive-candidate/S1-planet-end-spacer.stl
variants/banebots-775-k6/drive-candidate/S1-planet-inner-spacer.stl
variants/banebots-775-k6/drive-candidate/S1-planet.stl
variants/banebots-775-k6/drive-candidate/S1-sun.stl
variants/banebots-775-k6/drive-candidate/S2-carrier-lower.stl
variants/banebots-775-k6/drive-candidate/S2-carrier-upper.stl
variants/banebots-775-k6/drive-candidate/S2-fixed-ring.stl
variants/banebots-775-k6/drive-candidate/S2-planet-end-spacer.stl
variants/banebots-775-k6/drive-candidate/S2-planet-inner-spacer.stl
variants/banebots-775-k6/drive-candidate/S2-planet.stl
variants/banebots-775-k6/drive-candidate/S2-sun.stl
variants/banebots-775-k6/drive-candidate/S3-carrier-lower.stl
variants/banebots-775-k6/drive-candidate/S3-carrier-upper.stl
variants/banebots-775-k6/drive-candidate/S3-fixed-ring.stl
variants/banebots-775-k6/drive-candidate/S3-planet-end-spacer.stl
variants/banebots-775-k6/drive-candidate/S3-planet-inner-spacer.stl
variants/banebots-775-k6/drive-candidate/S3-planet.stl
variants/banebots-775-k6/drive-candidate/S3-sun.stl
variants/banebots-775-k6/fit-tests/bearing-seat-11.0mm-NO-POWER.stl
variants/banebots-775-k6/fit-tests/bearing-seat-11.1mm-NO-POWER.stl
variants/banebots-775-k6/fit-tests/bearing-seat-11.2mm-NO-POWER.stl
variants/banebots-775-k6/fit-tests/carrier-HAND-TEST-ONLY.stl
variants/banebots-775-k6/fit-tests/motor-face-slotted-TEMPLATE-NO-POWER.stl
variants/banebots-775-k6/fit-tests/planet-27T-HAND-TEST-print-three.stl
variants/banebots-775-k6/fit-tests/ring-72T-HAND-TEST.stl
variants/banebots-775-k6/fit-tests/shaft-fit-5.0mm-NO-POWER.stl
variants/banebots-775-k6/fit-tests/shaft-fit-5.1mm-NO-POWER.stl
variants/banebots-775-k6/fit-tests/shaft-fit-5.2mm-NO-POWER.stl
variants/banebots-775-k6/fit-tests/shaft-fit-5.3mm-NO-POWER.stl
variants/banebots-775-k6/fit-tests/stand-HAND-TEST-ONLY.stl
variants/banebots-775-k6/fit-tests/sun-18T-HAND-TEST.stl
variants/banebots-775-k6/socket-adapter/SA1-cassette-left.stl
variants/banebots-775-k6/socket-adapter/SA1-cassette-right.stl
variants/banebots-775-k6/socket-adapter/SA1-output-collar-spacer-FIT-SAMPLE.stl
variants/banebots-775-k6/static-fixture/TF1-rear-cradle-STATIC-ONLY.stl
variants/banebots-775-k6/static-fixture/TF1-tie-rod-standoff-STATIC-ONLY.stl
variants/banebots-775-k6/static-fixture/TF1-vise-plate-MOTOR-REMOVED-ONLY.stl
