ameerry1998/Nema-17-23-planetary-gear/(commit log)

2026-10-21 Add experimental BaneBots 775 K6 fit-test variant
    [bearing-seat-11.0mm-NO-POWER.step, bearing-seat-11.0mm-NO-POWER.stl, bearing-seat-11.1mm-NO-POWER.step, bearing-seat-11.1mm-NO-POWER.stl, bearing-seat-11.2mm-NO-POWER.step, bearing-seat-11.2mm-NO-POWER.stl, carrier-HAND-TEST-ONLY.step, carrier-HAND-TEST-ONLY.stl]
2026-10-21 Prioritize material-specific gearbox sizing and bench validation
2026-10-21 Add D1 printed gearbox candidate, material rationale and verified build pipeline
    [D1-gearbox-REFERENCE.step, S1-carrier-lower.step, S1-carrier-lower.stl, S1-carrier-upper.step, S1-carrier-upper.stl, S1-cartridge-REFERENCE.step, S1-case-lower.step, S1-case-lower.stl]
2026-10-21 Add retained socket attachment and screen shaft contact loads
    [D1-gearbox-REFERENCE.step, S1-carrier-lower.step, S1-carrier-upper.step, S1-cartridge-REFERENCE.step, S1-case-lower.step, S1-case-upper.step, S1-fixed-ring.step, S1-input-long-spacer.step]
2026-10-21 Add motor-removed static-load fixture and test procedure
    [D1-gearbox-REFERENCE.step, S1-carrier-lower.step, S1-carrier-upper.step, S1-cartridge-REFERENCE.step, S1-case-lower.step, S1-case-upper.step, S1-fixed-ring.step, S1-input-long-spacer.step]
2026-10-21 Clarify separate printing and add running-brake feasibility calculations
2026-10-21 Fix rotating fastener collisions and specify planet pin retention
    [D1-gearbox-REFERENCE.step, S1-carrier-lower.step, S1-carrier-lower.stl, S1-carrier-upper.step, S1-cartridge-REFERENCE.step, S1-case-lower.step, S1-case-upper.step, S1-fixed-ring.step]
2026-10-21 Account for orbiting planet mass and pin loads
    [test-results-template.csv]
